nassim78belabed-gif/ipod-ok-computer/README.md

# iPod OK Computer Edition : ESP32-S3




Un iPod Classic refait de zéro : lecteur MP3 sur carte SD, écran couleur 2,4", DAC I2S et 6 boutons, pour environ 33 € de composants. Firmware, PCB (2 cartes) et boîtier 3D sont conçus de bout en bout, de la lecture des tags ID3 au transfert de musique par WiFi.

> Projet repris de zéro en septembre 2026 avec un nouveau brochage (firmware fonctionnel sur breadboard depuis fin septembre).

## Ce que j'ai fait

- **Firmware** en C++ (Arduino / ESP32) : navigation Artistes / Albums / Morceaux, lecture MP3 en I2S, pochettes, lecture des tags ID3.
- **Transfert de musique par WiFi** depuis un téléphone ou un PC, avec rangement automatique d'après les tags.
- **PCB** en deux cartes, générées par script, avec leurs fichiers de fabrication.
- **Boîtier** en deux coques, généré en CadQuery à partir des cotes des PCB.
- **Easter eggs** par album (thèmes, messages, code secret aux boutons).

## Matériel

| Composant | Détail |
|---|---|
| Microcontrôleur | ESP32-S3-DevKitC-1 **N16R8** (16 Mo flash, 8 Mo PSRAM octal) |
| Écran | ILI9341 2,4" 240x320 SPI, module avec lecteur SD intégré (tactile non utilisé) |
| Audio | DAC I2S PCM5102A (module **CJMCU-5102**, 11 broches), sortie jack LINE OUT |
| Commandes | 6 boutons poussoirs vers GND (pull-up interne) |

## Coût

Prix indicatifs (AliExpress / Amazon).

| Composant | Prix |
|---|---|
| ESP32-S3-DevKitC-1 N16R8 | ~8 € |
| Écran ILI9341 2,4" avec lecteur SD | ~8 € |
| DAC PCM5102A (module CJMCU-5102) | ~5 € |
| Carte microSD 32 Go | ~5 € |
| 6 boutons poussoirs | ~2 € |
| Breadboard + fils (prototype) | ~5 € |
| **Total version breadboard** | **~33 €** |

Version finale V1, portable sur batterie :

| Composant | Prix |
|---|---|
| ESP32, écran, DAC, microSD, boutons (voir ci-dessus) | ~28 € |
| Batterie LiPo YL 603450 (3,7 V, 1200 mAh, protégée) | ~8 € |
| Chargeur TP4056 | ~1 € |
| Régulateur 3,3 V, interrupteur, prise JST | ~3 € |
| PCB (2 cartes, fabrication type JLCPCB) | ~10 € |
| Boîtier imprimé en 3D | ~15 € |
| **Total version portable V1** | **~65 €** |

La V2 (molette cliquable iPod 4G à la place des boutons) ajoute le prix de la molette : ~10 à 15 € d'occasion.

## Fonctionnalités

Validées sur breadboard (firmware `firmware/ipod/`) :
- **Menus** Artistes / Albums / Morceaux, écran **Lecture en cours** (pochette, progression, volume), enchaînement des morceaux, pause, précédent / suivant, avance rapide.
- **Pochettes** : image intégrée au MP3, `/covers/<album>.jpg|.bmp`, `cover.jpg` / `folder.jpg` du dossier ; les JPG sont redimensionnés pour remplir le cadre.
- **Transfert MP3 par WiFi** : menu « Transfert MP3 », envoi de plusieurs MP3 d'un coup depuis un téléphone ou un PC, rangement automatique dans `/Music/<artiste>/<album>/` d'après les tags. Le WiFi n'est allumé que dans ce menu.
- **Easter eggs par album** : thème de couleurs, messages sur certaines pistes (fixes, défilants, « glitch ») et code secret aux boutons, décrits dans un fichier `easter.txt` par album (voir le dossier `easter/`).
- **Commandes série** : mêmes actions que les boutons (`m p < > + -`) et maintenance de la SD (liste, suppression, diagnostic des tags), via `outils/serie.py`.

Volume limité à 19/21 (au-delà, la sortie du DAC sature) ; départ à 16.

## Difficultés rencontrées

- **Écran et SD sur le même bus SPI.** L'ILI9341 ne libère pas sa broche SDO et bloquait la SD. Solution : le MISO de l'écran n'est pas câblé, et le firmware relâche toujours un CS avant d'activer l'autre.
- **Broches interdites.** Avec la PSRAM octal du N16R8, les GPIO 26 à 37 sont réservés : le brochage a dû être refait autour de cette contrainte.
- **Crash de la bibliothèque audio.** Certains MP3 provoquaient une division par zéro dans ESP32-audioI2S. J'ai corrigé la bibliothèque et gardé une copie patchée dans le dépôt (voir `LISEZMOI.md` du dossier).
- **WiFi et audio.** Le WiFi perturbait le son, donc il n'est allumé que dans le menu de transfert.
- **Saturation du DAC.** Au-delà de 19/21, la sortie sature : le volume est plafonné.
- **Passage au PCB.** Les cartes sont générées par script plutôt que dessinées à la main, ce qui permet de modifier le brochage et de régénérer tout le routage d'un coup.

## Brochage

| Fonction | GPIO |
|---|---|
| SPI SCK / MOSI / MISO (écran + SD) | 8 / 17 / 18 |
| SD CS | 16 |
| TFT CS / DC / RST | 11 / 9 / 10 |
| I2S BCK / DIN / LRCK | 7 / 6 / 5 |
| Boutons MENU / PLAY / PREV / NEXT / VOL+ / VOL- | 42 / 41 / 40 / 39 / 38 / 1 |

Rétroéclairage de l'écran sur 3V3 direct. Détails et contraintes : [hardware/wiring.md](hardware/wiring.md).

## PCB et boîtier

- **PCB v_final1** ([hardware/pcb_v_final1](hardware/pcb_v_final1/LISEZ-MOI.md)) : 2 cartes reliées par câble.
  - Carte logique (77 x 95 mm) : ESP32-S3 DevKit + PCM5102A + connecteurs vers l'écran, la SD et la façade boutons.
  - Carte façade (42,6 x 72,2 mm) : les 6 boutons en grille 2x3.
  - Le module écran ILI9341+SD reste externe, câblé à la carte logique.
  - Les cartes sont générées par script (`generateur/`) et les fichiers KiCad du PCB sont dans `kicad/`. [CONNEXIONS.md](hardware/pcb_v_final1/CONNEXIONS.md) liste toutes les connexions et tient lieu de schéma.
- **Boîtier v1** ([hardware/boitier_v1](hardware/boitier_v1/LISEZ-MOI.md)) : 2 coques (avant + arrière), 83 x 131 x 27 mm, générées en CadQuery à partir des cotes des PCB. **Provisoire** : plus large que le PCB pour laisser place à un écran et à des accessoires.

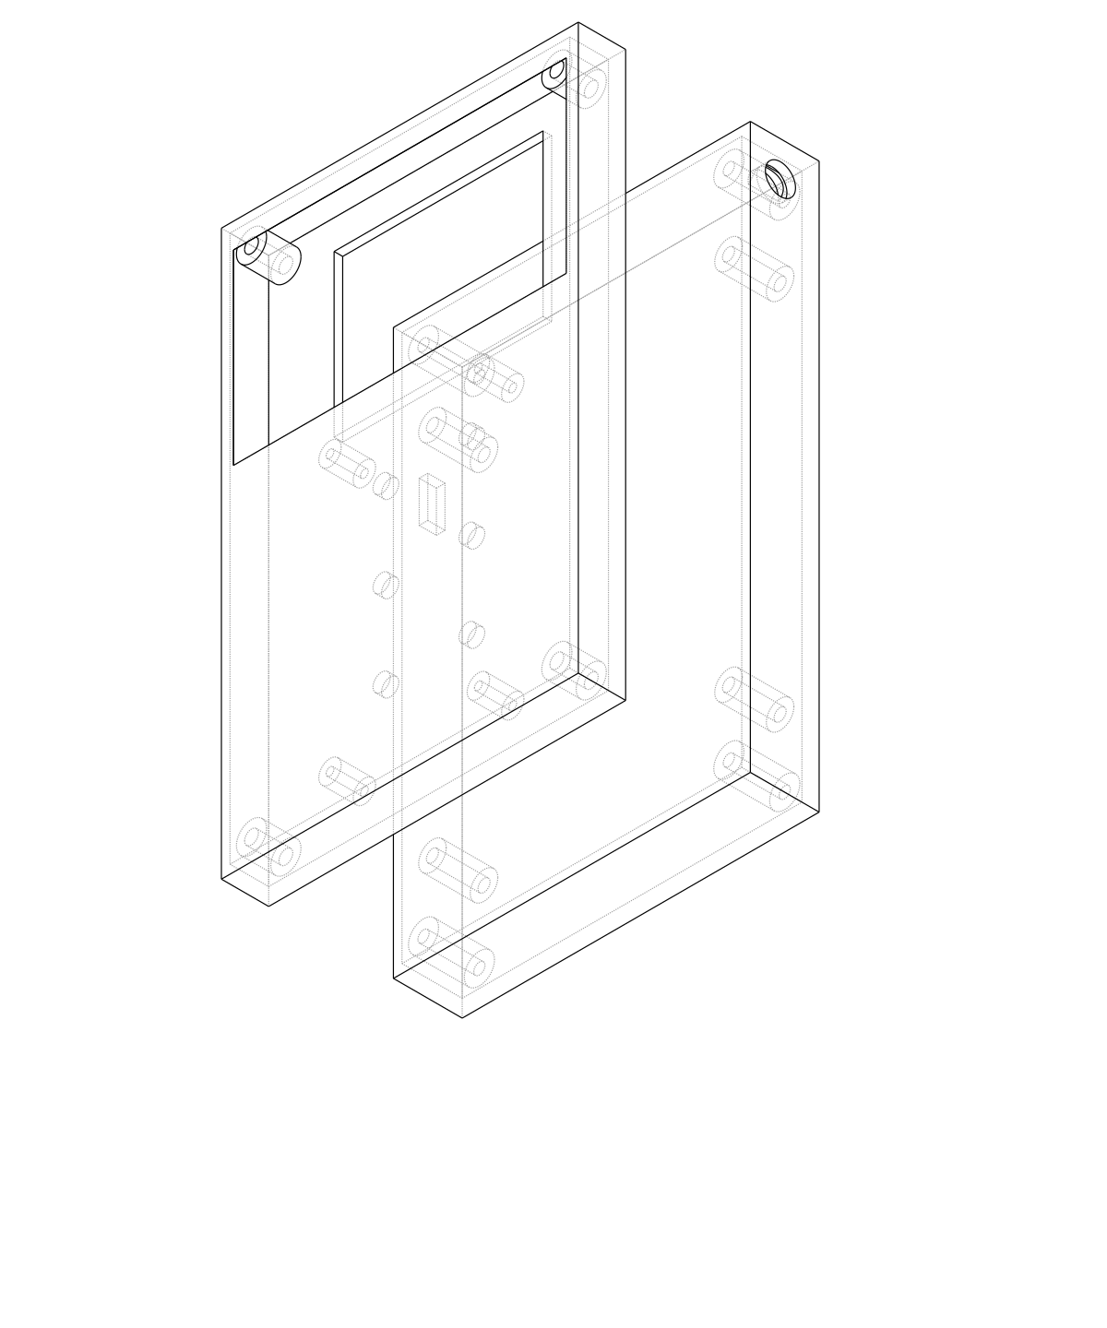
[picture p1: hardware/boitier_v1/preview_iso.png]
Boîtier


## Avancement

| Étape | État |
|---|---|
| Carte : puce, flash 16 Mo, PSRAM 8 Mo | ✅ testé (`test_carte`) |
| 1. SD : montage, liste, écriture/relecture | ✅ testé (`test_sd`, `liste_sd`) |
| Lecture des tags ID3 et du format MP3 | ✅ testé (`tags_sd`) |
| 2. Écran + SD + pochette | ✅ testé (`test_ecran_sd`) |
| 3. Boutons avec anti-rebond | ⏳ géré par le firmware, test dédié prêt (`test_boutons`) mais pas lancé |
| 4. Lecture MP3 vers le PCM5102A en I2S | ✅ testé (`test_bip`, `test_audio`) |
| 5. Interface iPod : Artistes, Albums, Morceaux, Lecture en cours, volume | ✅ firmware `firmware/ipod/` |
| 6. Transfert MP3 par WiFi | ✅ validé (25 MP3, ~0,3 Mo/s) |
| Easter eggs par album | ✅ essayés sur la carte |
| Améliorations d'interface (moteur d'affichage en PSRAM, polices, Cover Flow, playlists…) | ⏳ prévues |
| PCB : support DAC 11 broches, alimentation, découplage, pistes I2S courtes | ⏳ corrections à faire avant fabrication |
| V1 sur batterie (LiPo YL 603450, chargeur, mesure de tension) | ⏳ à ajouter au PCB |
| V2 : molette cliquable iPod 4G | ⏳ plus tard |

Tests faits sur breadboard uniquement : le PCB n'est pas encore fabriqué.

## Compilation

Outils : Arduino IDE 2 ou [arduino-cli](https://arduino.github.io/arduino-cli/), core **esp32 by Espressif 3.x**.

Bibliothèques : **Adafruit ILI9341** (+ Adafruit GFX, Adafruit BusIO), **TJpg_Decoder** (pochettes JPG). Audio : **ESP32-audioI2S** (schreibfaul1) 4.0.0, **copie patchée incluse dans le dépôt** (`firmware/ipod/src/ESP32-audioI2S/`, correctif d'une division par zéro sur certains MP3, voir son `LISEZMOI.md`) : rien à installer pour le firmware principal.

Réglages de la carte :

| Option | Valeur |
|---|---|
| Carte | ESP32S3 Dev Module |
| PSRAM | OPI PSRAM |
| Flash Size | 16 Mo |
| Partition | 16M Flash (3MB APP/9.9MB FATFS) |
| USB CDC On Boot | selon le port USB, voir ci-dessous |

**USB CDC On Boot** dépend du port USB branché :
- port **« COM »** (puce CH343) : désactivé, `Serial` sort sur l'UART0 ;
- port **« USB »** (USB natif) : activé, `Serial` sort sur l'USB natif.

Le firmware et les sketches de test écrivent sur `Serial` et `Serial0` : les messages restent lisibles quel que soit le port.

Exemple avec arduino-cli (port COM10) :

```
arduino-cli compile -u -p COM10 --fqbn esp32:esp32:esp32s3:PSRAM=opi,FlashSize=16M,CDCOnBoot=default,PartitionScheme=app3M_fat9M_16MB firmware/ipod
```

Remplacer `CDCOnBoot=default` par `CDCOnBoot=cdc` pour activer le CDC.

## Firmware

`firmware/ipod/` : `ipod.ino` (navigation, audio, boutons), `bibliotheque.ino` (tags ID3), `ecran.ino` (affichage), `easter.ino` (easter eggs), `web.ino` + `page_web.h` (WiFi, transfert), `ipod.h` (réglages).

## Sketches de test

| Sketch | Rôle |
|---|---|
| `firmware/tests/test_carte` | Infos puce, flash, test PSRAM, état des broches boutons |
| `firmware/tests/test_sd` | Montage SD, taille, liste de la racine, écriture/relecture de `test.txt` |
| `firmware/tests/liste_sd` | Liste récursive de toute la carte SD |
| `firmware/tests/tags_sd` | Tags ID3 (v1, v2.2 à 2.4) et format MPEG des MP3 de `/Music` |
| `firmware/tests/test_ecran_sd` | Écran (couleurs, texte, pochette) + liste de la SD |
| `firmware/tests/test_boutons` | Les 6 boutons avec anti-rebond (prêt, pas encore lancé) |
| `firmware/tests/test_bip` | Bip I2S vers le DAC |
| `firmware/tests/test_audio` | Lecture d'un MP3 de la SD vers le DAC |

## Carte SD

- Format **FAT32**
- Musique rangée dans `/Music/Artiste/Album/`, fichiers MP3 avec tags ID3 complets (titre, artiste, album, numéro de piste)
- MP3 testés : MPEG1 Layer III, 44,1 ou 48 kHz, stéréo

Pour ajouter de la musique sans retirer la carte : menu **Transfert MP3** sur l'iPod, puis page web (l'adresse s'affiche à l'écran) ou `curl -F "f=@fichier.mp3" http://<adresse>/api/envoi`.

Pour de bons fichiers : albums achetés sans DRM (Bandcamp, Qobuz, 7digital) ou CD rippés (Exact Audio Copy, fre:ac), qui arrivent avec tags et pochette.

## Structure du dépôt

```
ipod-ok-computer/
├── firmware/
│   ├── ipod/          # Firmware principal
│   └── tests/         # Sketches de test (un dossier par sketch)
├── easter/            # Modèles de fichiers easter.txt (un par album) + aperçus
├── outils/            # Scripts : commandes série, encodage de CD, journal série
├── hardware/
│   ├── wiring.md      # Brochage et contraintes
│   ├── pcb_v_final1/  # PCB actuel : carte logique + carte boutons (KiCad, gerbers, générateurs)
│   │   └── CONNEXIONS.md  # Liste des connexions (tient lieu de schéma)
│   ├── boitier_v1/    # Boîtier provisoire (STEP/STL, script CadQuery gen_case.py)
│   └── archives/      # Anciennes versions (v7, v8, breakout clickwheel), référence uniquement
└── LICENSE
```

## Licence

Le projet est sous licence **GPL-3.0**, voir [LICENSE](LICENSE).

Le dossier `firmware/ipod/src/ESP32-audioI2S/` est une copie patchée de la bibliothèque [ESP32-audioI2S](https://github.com/schreibfaul1/ESP32-audioI2S) (schreibfaul1), également sous **GPL-3.0** : sa licence d'origine est conservée dans ce dossier. Le projet entier est donc publié sous GPL-3.0.
