nassim78belabed-gif/ipod-ok-computer/easter/apercu/apercu.png

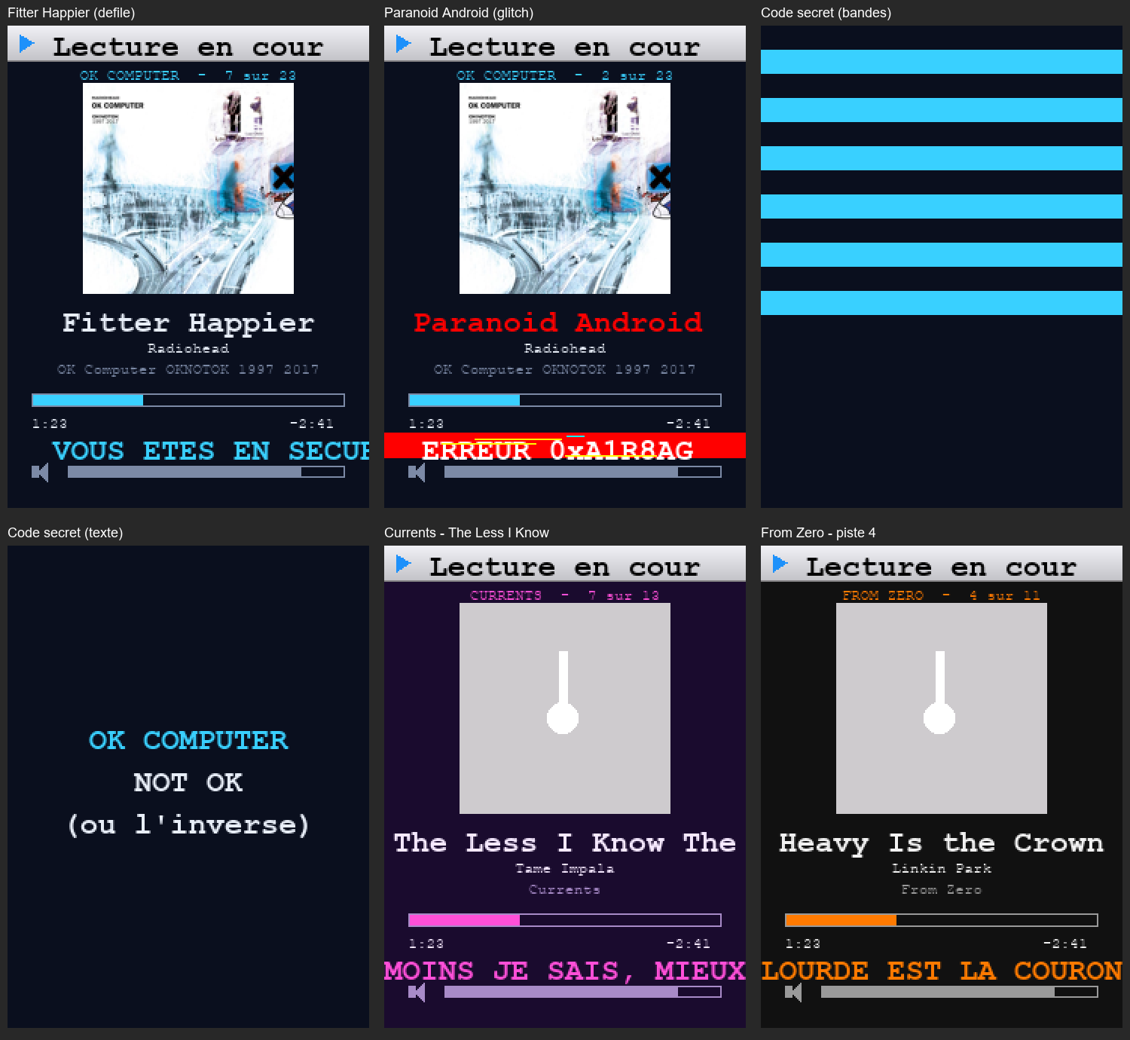
easter/apercu/apercu.png
