nassim78belabed-gif/ipod-ok-computer/hardware/boitier_v1/back_top.png

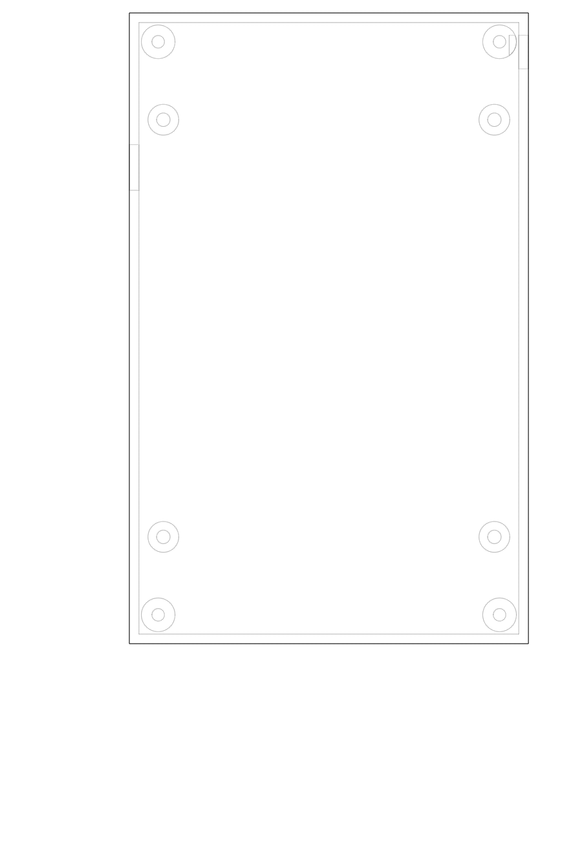
hardware/boitier_v1/back_top.png
