nassim78belabed-gif/ipod-ok-computer/hardware/boitier_v1/front_top.png

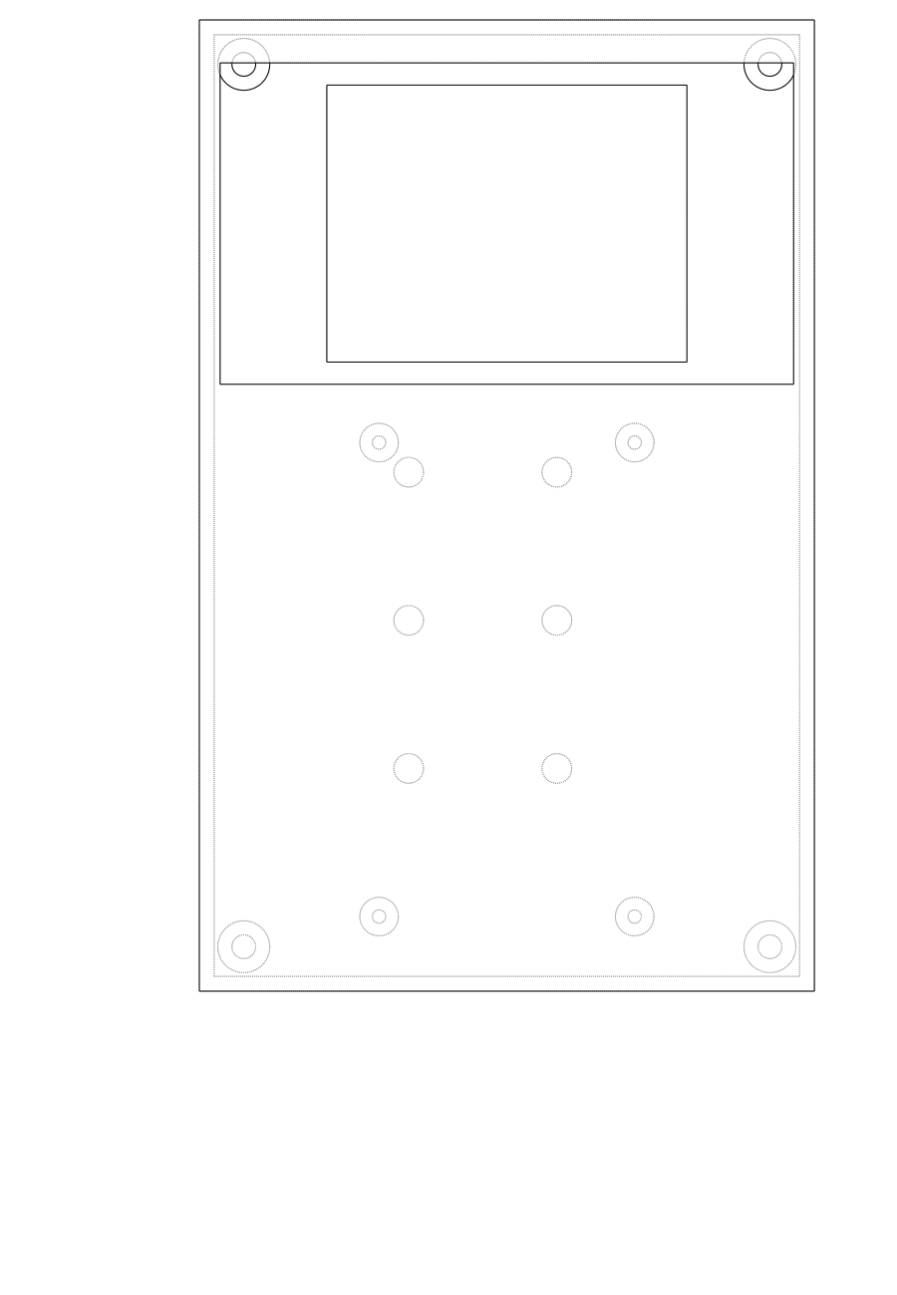
hardware/boitier_v1/front_top.png
