nassim78belabed-gif/ipod-ok-computer/hardware/pcb_v_final1/buttons/apercu_buttons.png

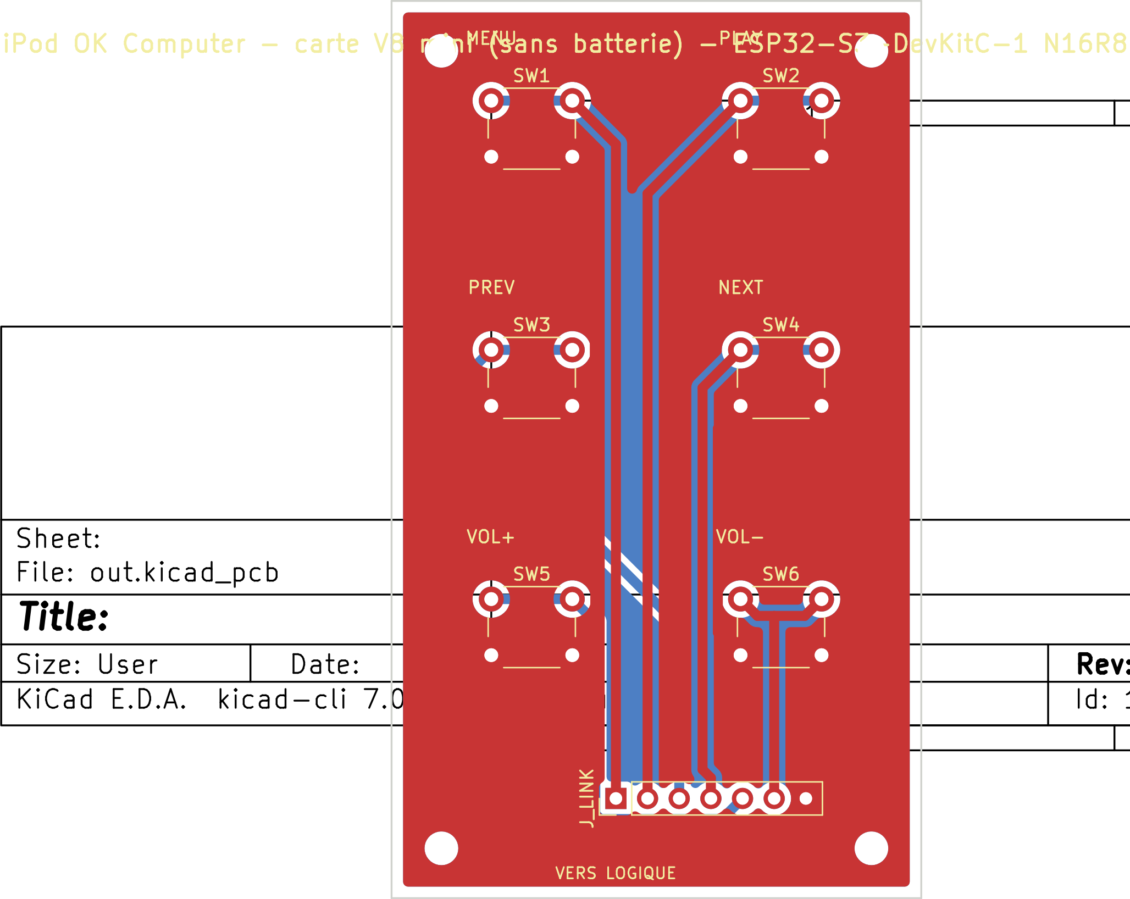
hardware/pcb_v_final1/buttons/apercu_buttons.png
