nassim78belabed-gif/ipod-ok-computer/hardware/pcb_v_final1/logic/apercu_logic.png

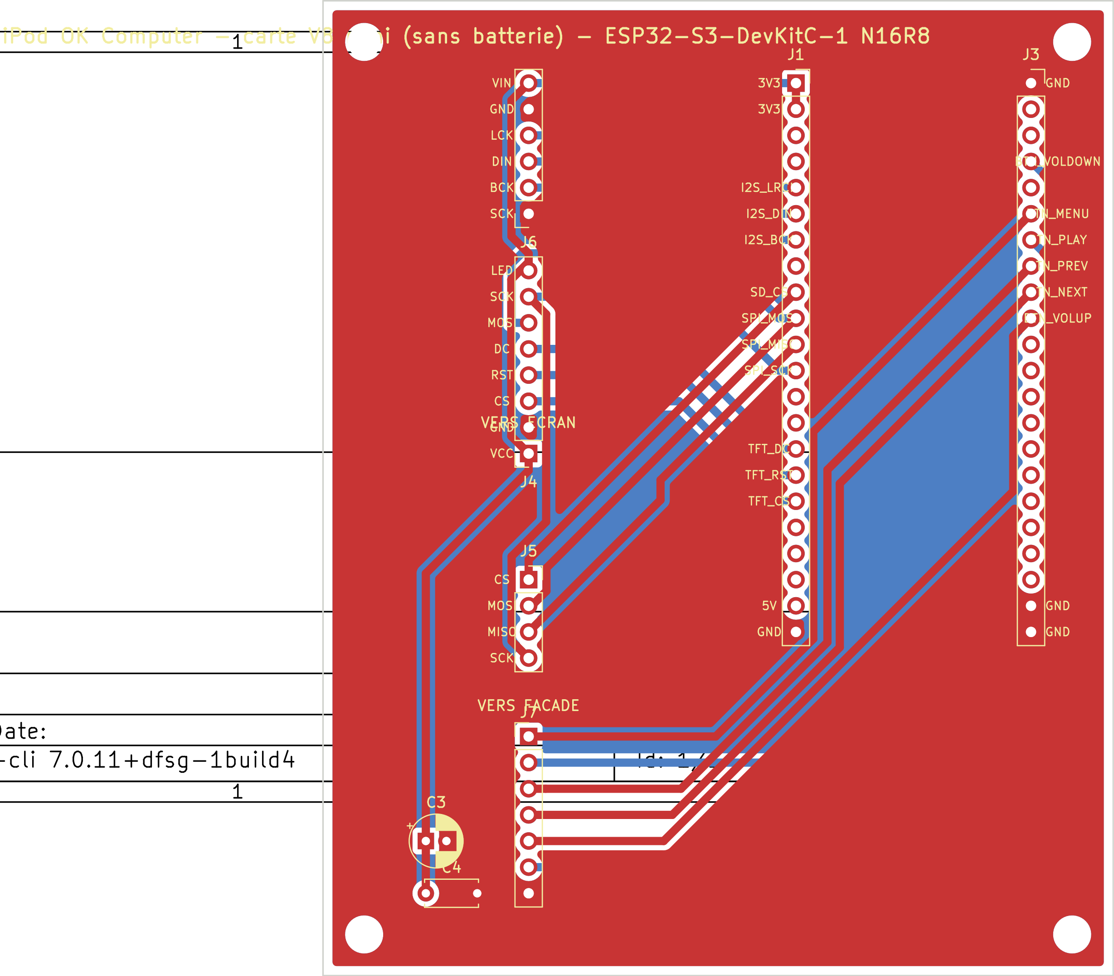
hardware/pcb_v_final1/logic/apercu_logic.png
