nassim78belabed-gif/ipod-ok-computer/hardware/archives/clickwheel_breakout/BOM.csv

Comment | Designator | Footprint | Manufacturer Part
FPC connector 0.5mm 8pos top contact | J1 | GH:SFV8R2STE1HLF | SFV8R-2STE1HLF (Amphenol/FCI)
