nassim78belabed-gif/ipod-ok-computer/hardware/boitier_v1/boitier_assemble_ecarte.step

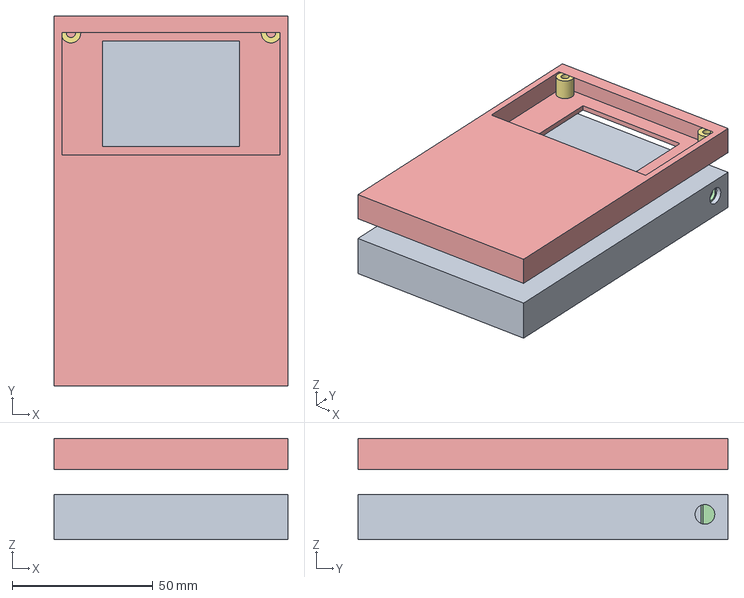
[picture p7: CAD file, 2026-10-21]
hardware/boitier_v1/boitier_assemble_ecarte.step
83.0 x 131.2 x 36.0 mm
back
front
