nassim78belabed-gif/ipod-ok-computer/hardware/boitier_v1/front_shell.step

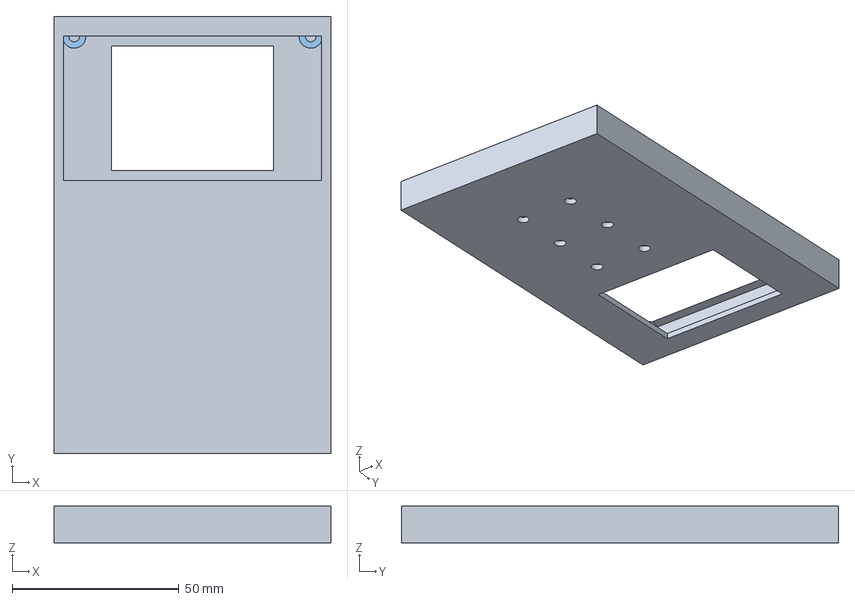
[picture p8: CAD file, 2026-10-21]
hardware/boitier_v1/front_shell.step
83.0 x 131.2 x 11.0 mm
