nassim78belabed-gif/ipod-ok-computer/hardware/pcb_v_final1/buttons/buttons_v_final1.step

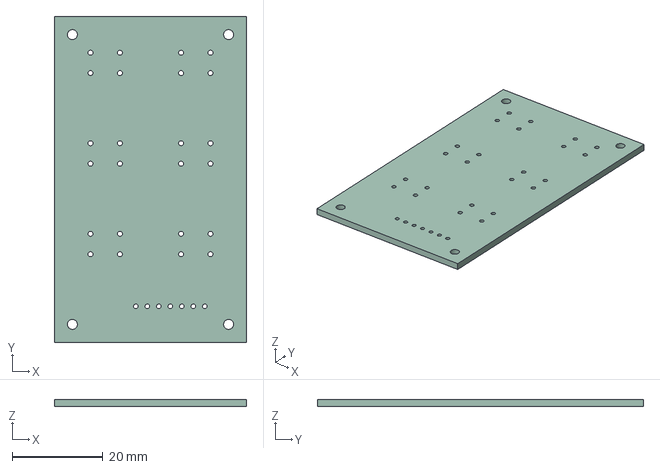
[picture p9: CAD file, 2026-10-21]
hardware/pcb_v_final1/buttons/buttons_v_final1.step
42.5 x 72.0 x 1.60 mm
