nassim78belabed-gif/ipod-ok-computer/hardware/pcb_v_final1/logic/logic_v_final1.step

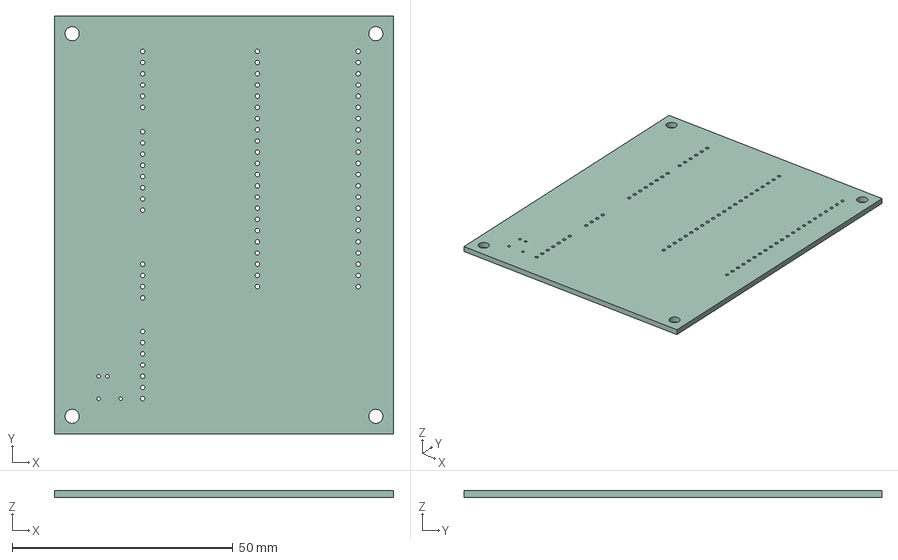
[picture p10: CAD file, 2026-10-21]
hardware/pcb_v_final1/logic/logic_v_final1.step
76.9 x 94.7 x 1.60 mm
