nassim78belabed-gif/ipod-ok-computer/hardware/boitier_v1/back_shell.step

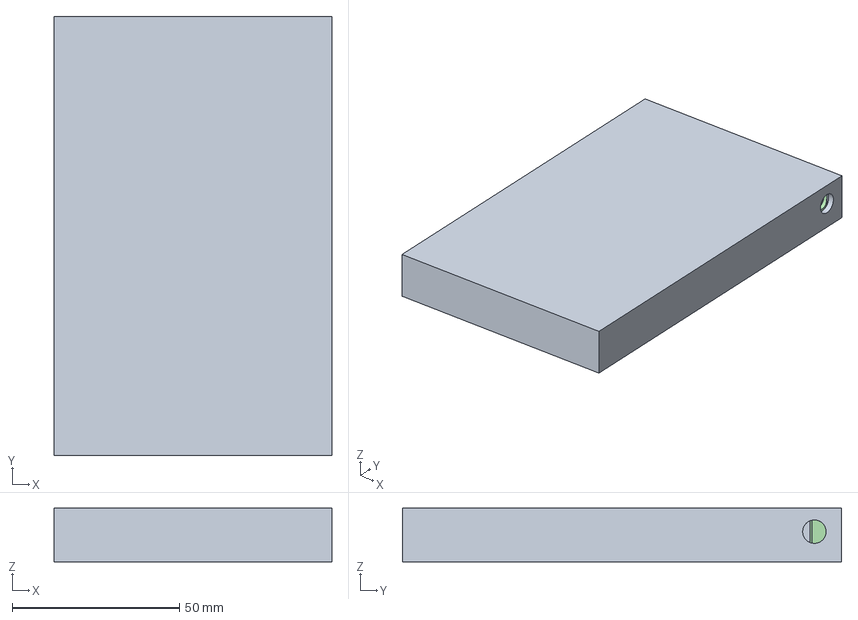
[picture p11: CAD file, 2026-10-21]
hardware/boitier_v1/back_shell.step
83.0 x 131.2 x 16.0 mm
