nassim78belabed-gif/ipod-ok-computer/(list of files, cad)

Other CAD files:
hardware/boitier_v1/back_shell.stl
hardware/boitier_v1/front_shell.stl
