nassim78belabed-gif/ipod-ok-computer/hardware/archives/ipod_v7/schema_ipod_v7.pdf

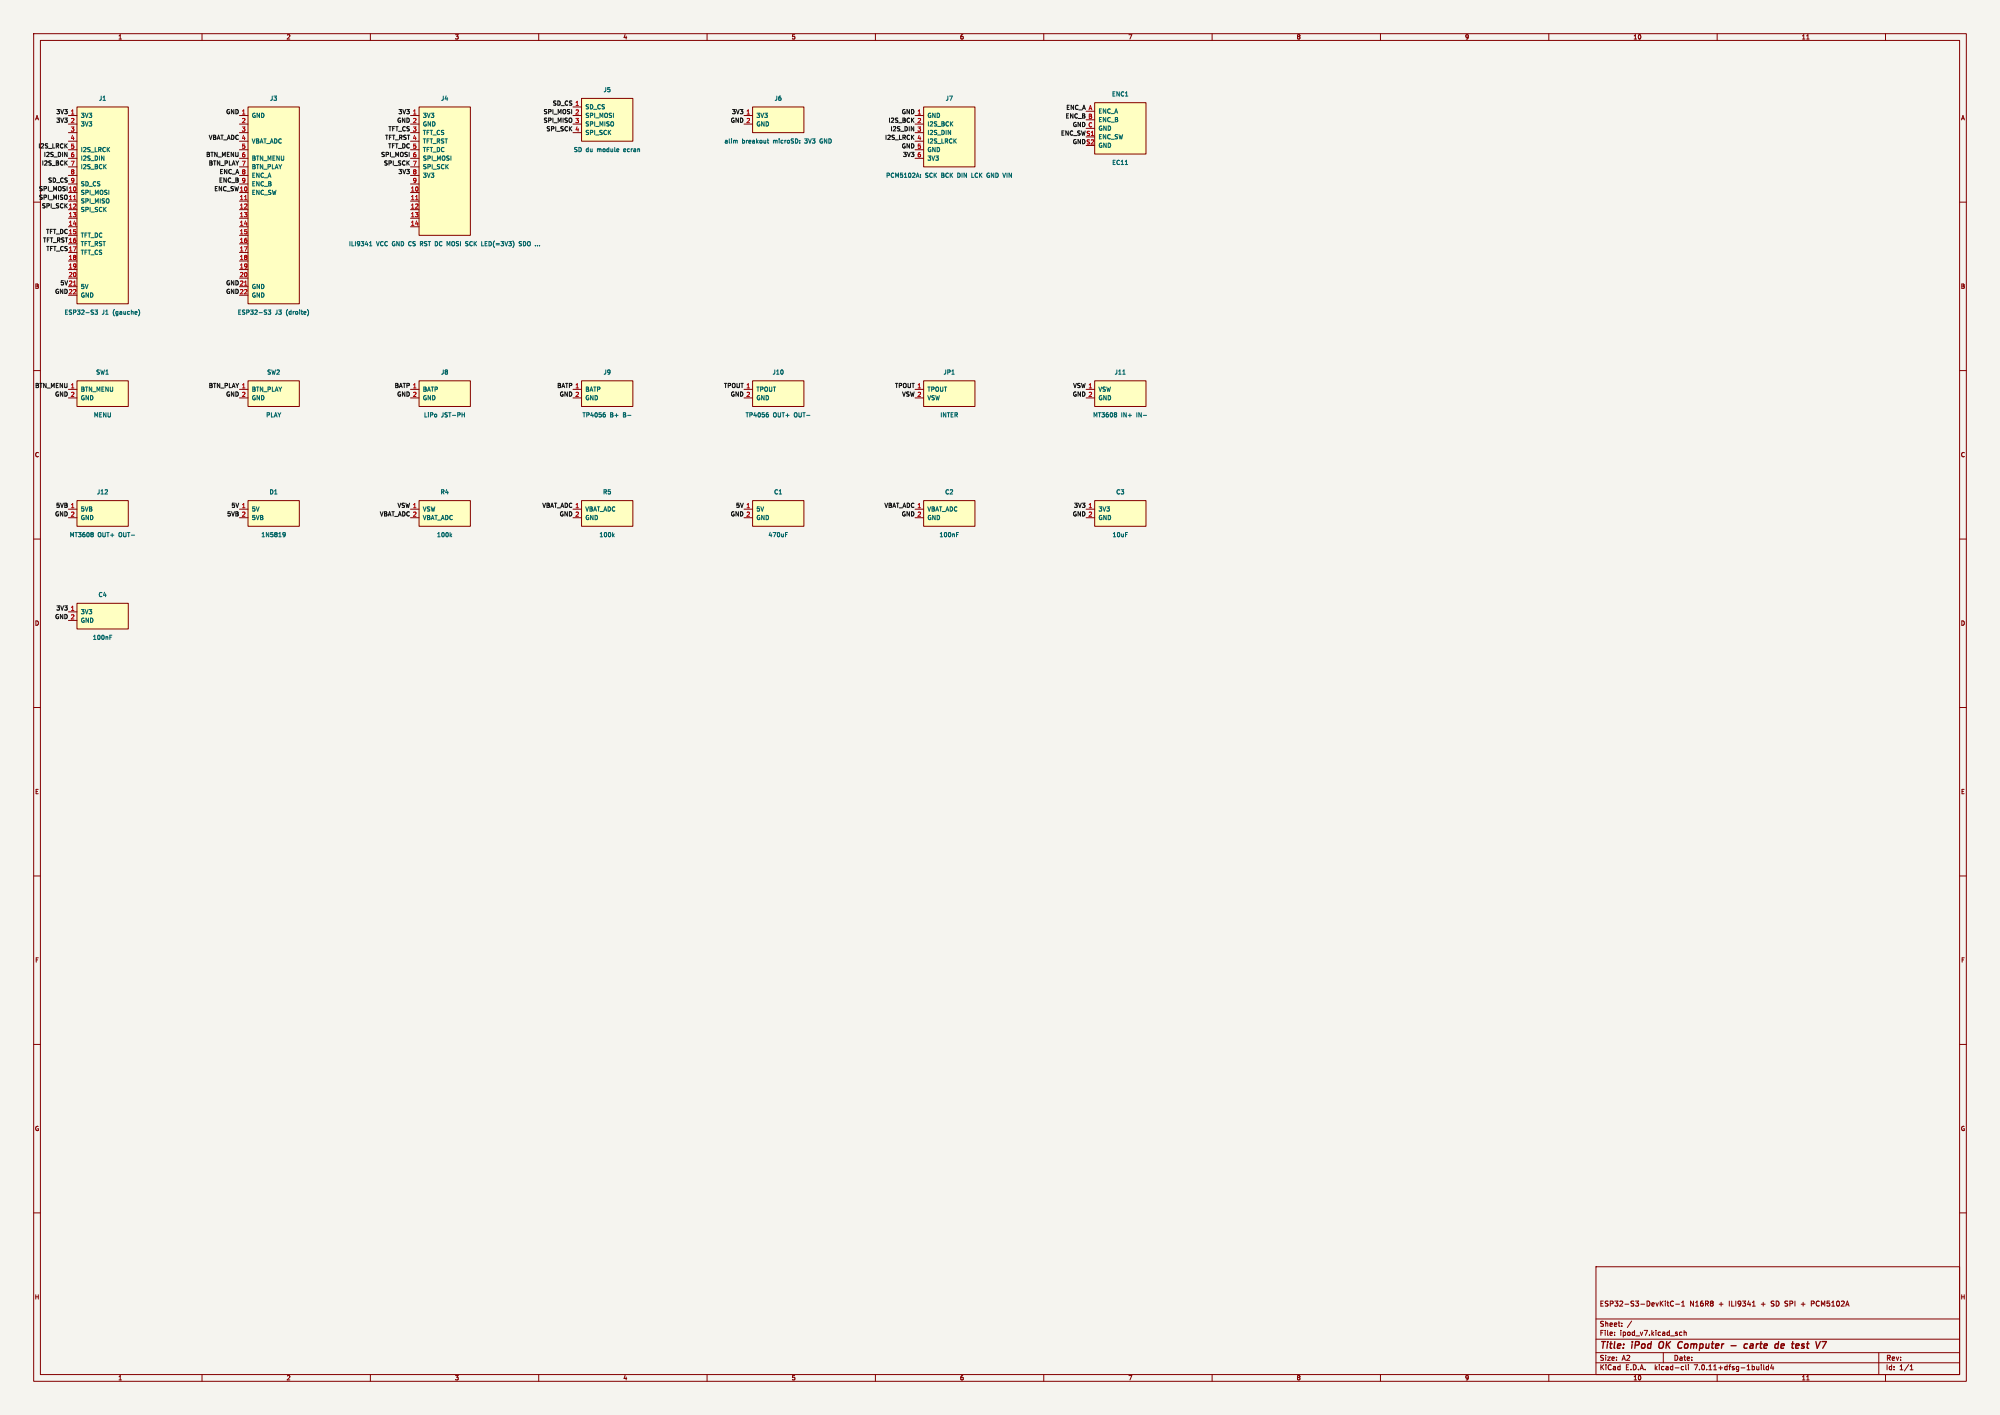
[picture p12: page 1]

J7 PCM5102A: SCK BCK DIN LCK GND VIN
