nassim78belabed-gif/ipod-ok-computer/hardware/archives/ipod_v8/schema_ipod_v8.pdf

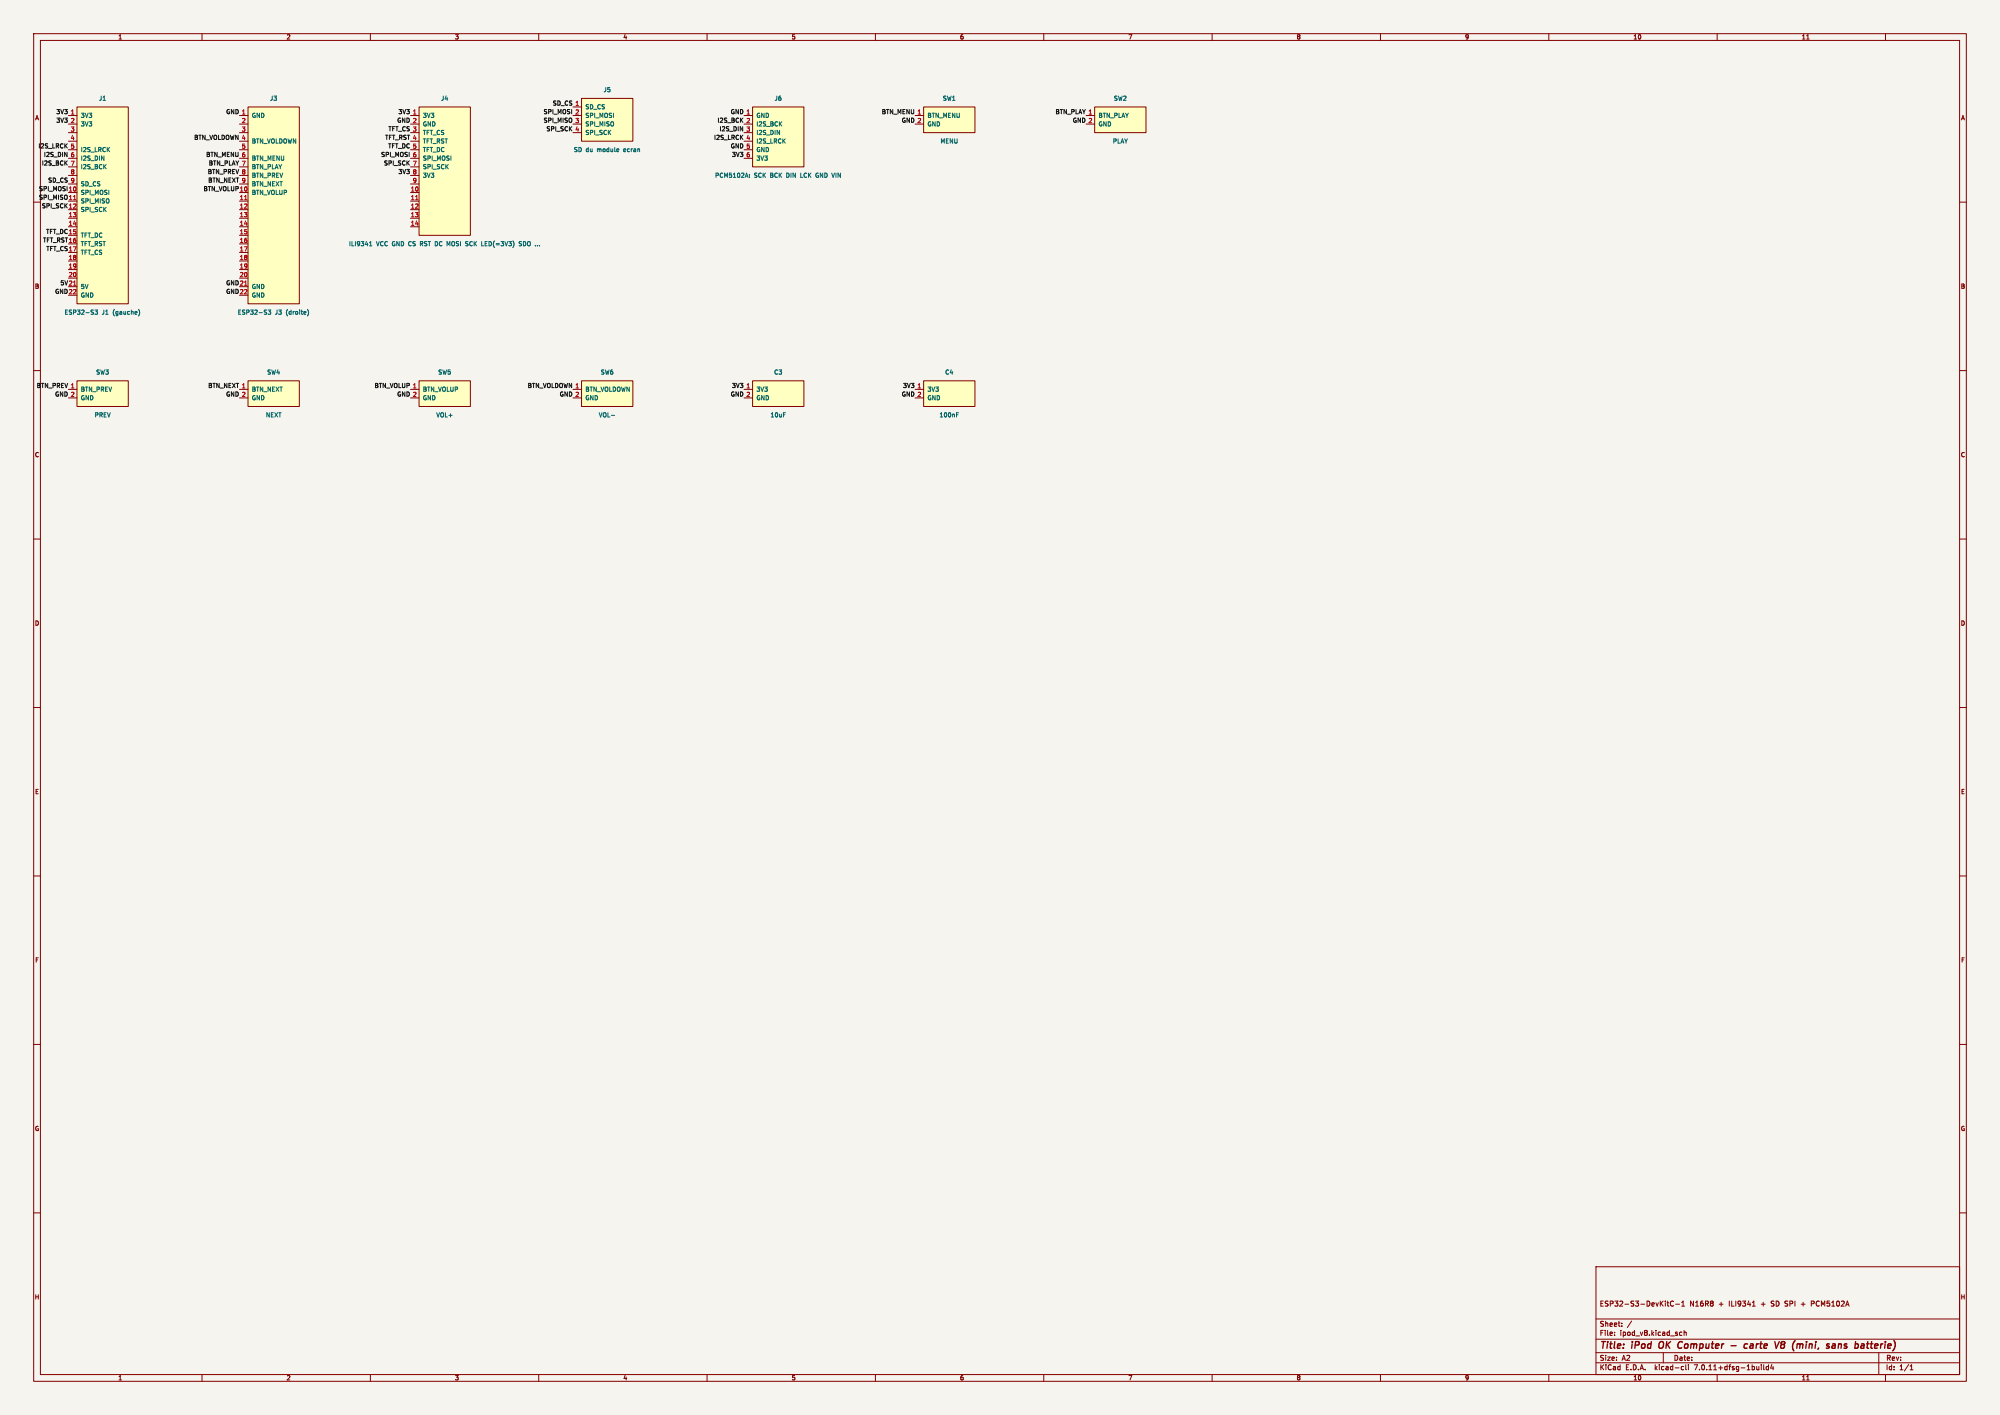
[picture p13: page 1]

J6 PCM5102A: SCK BCK DIN LCK GND VIN
