nassim78belabed-gif/ipod-ok-computer/hardware/pcb_v_final1/logic/kicad/logic_v_final1.kicad_pcb

## KiCad design hardware/pcb_v_final1/logic/kicad/logic_v_final1.kicad_pcb (2026-10-21)

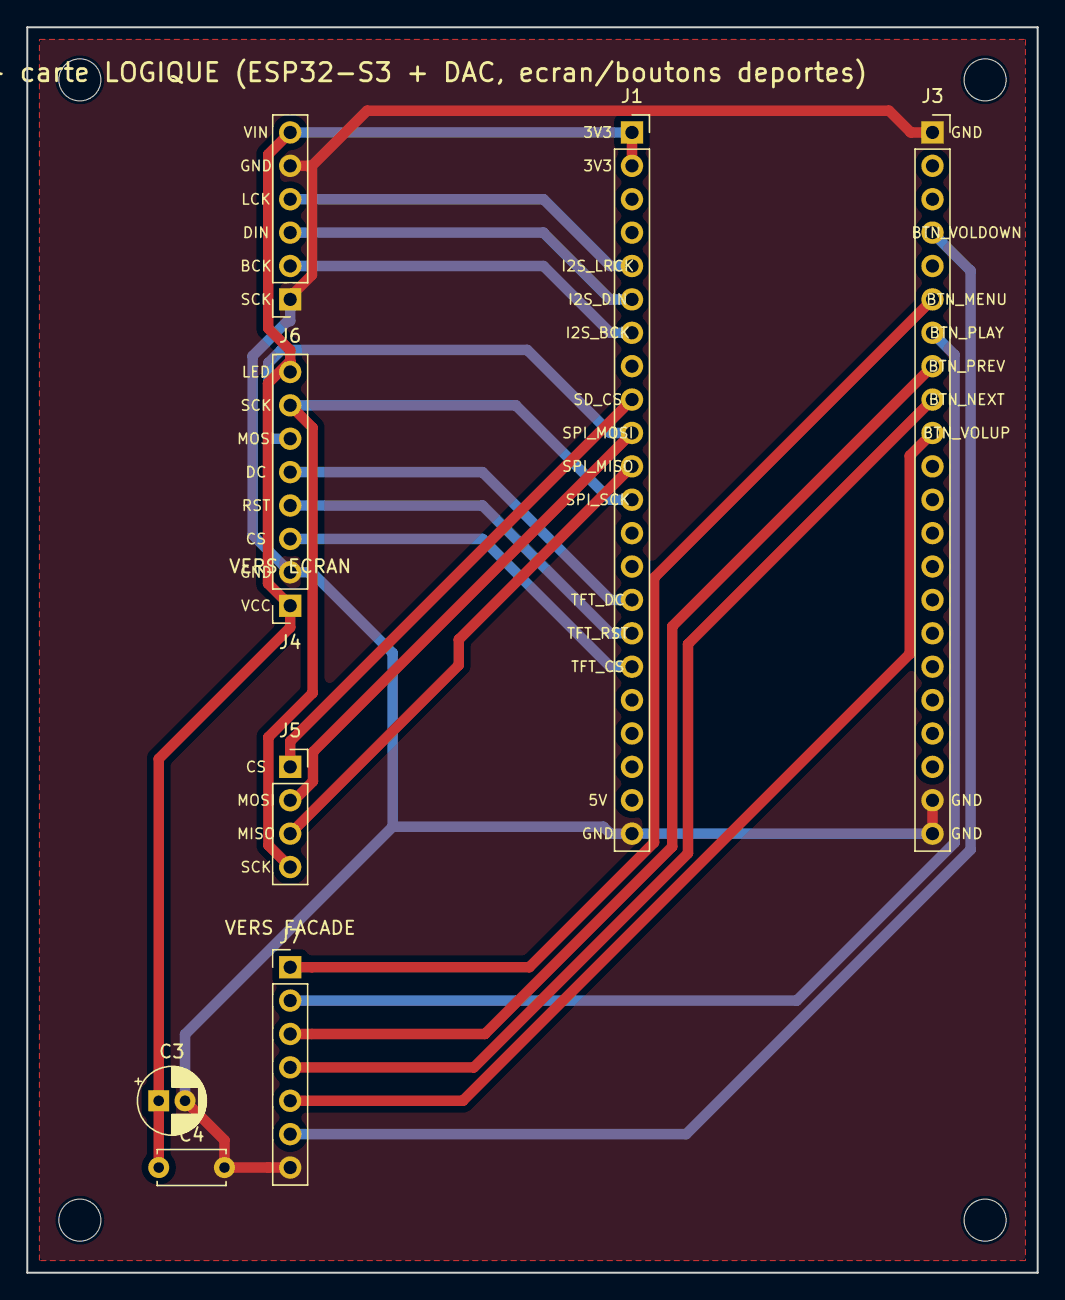
[picture p14: board logic_v_final1.kicad_pcb from above]

Board: 2 copper layers, 76.9 x 94.7 mm, 12 parts (0 on the bottom side), 18 nets.

Parts:
C3: 10uF; CP_Radial_D5.0mm_P2.00mm
C4: 100nF; C_Disc_D5.0mm_W2.5mm_P5.00mm
H1, H2, H3, H4: MountingHole_3.2mm_M3
J1: ESP32-S3 J1 (gauche); PinSocket_1x22_P2.54mm_Vertical
J3: ESP32-S3 J3 (droite); PinSocket_1x22_P2.54mm_Vertical
J4: VERS ECRAN: VCC GND CS RST DC MOSI SCK LED; PinSocket_1x08_P2.54mm_Vertical
J5: VERS SD ecran; PinSocket_1x04_P2.54mm_Vertical
J6: PCM5102A: SCK BCK DIN LCK GND VIN; PinSocket_1x06_P2.54mm_Vertical
J7: VERS FACADE: MENU PLAY PREV NEXT VOL+ VOL- GND; PinHeader_1x07_P2.54mm_Vertical

Connections:
3V3: C3.1, C4.1, J1.1, J1.2, J4.1, J4.8, J6.6
BTN_MENU: J3.6, J7.1
BTN_NEXT: J3.9, J7.4
BTN_PLAY: J3.7, J7.2
BTN_PREV: J3.8, J7.3
BTN_VOLDOWN: J3.4, J7.6
BTN_VOLUP: J3.10, J7.5
GND: C3.2, C4.2, J1.22, J3.1, J3.21, J3.22, J4.2, J6.1, J6.5, J7.7
I2S_BCK: J1.7, J6.2
I2S_DIN: J1.6, J6.3
I2S_LRCK: J1.5, J6.4
SD_CS: J1.9, J5.1
SPI_MISO: J1.11, J5.3
SPI_MOSI: J1.10, J4.6, J5.2
SPI_SCK: J1.12, J4.7, J5.4
TFT_CS: J1.17, J4.3
TFT_DC: J1.15, J4.5
TFT_RST: J1.16, J4.4
