nassim78belabed-gif/ipod-ok-computer/hardware/pcb_v_final1/buttons/kicad/buttons_v_final1.kicad_pcb

## KiCad design hardware/pcb_v_final1/buttons/kicad/buttons_v_final1.kicad_pcb (2026-10-21)

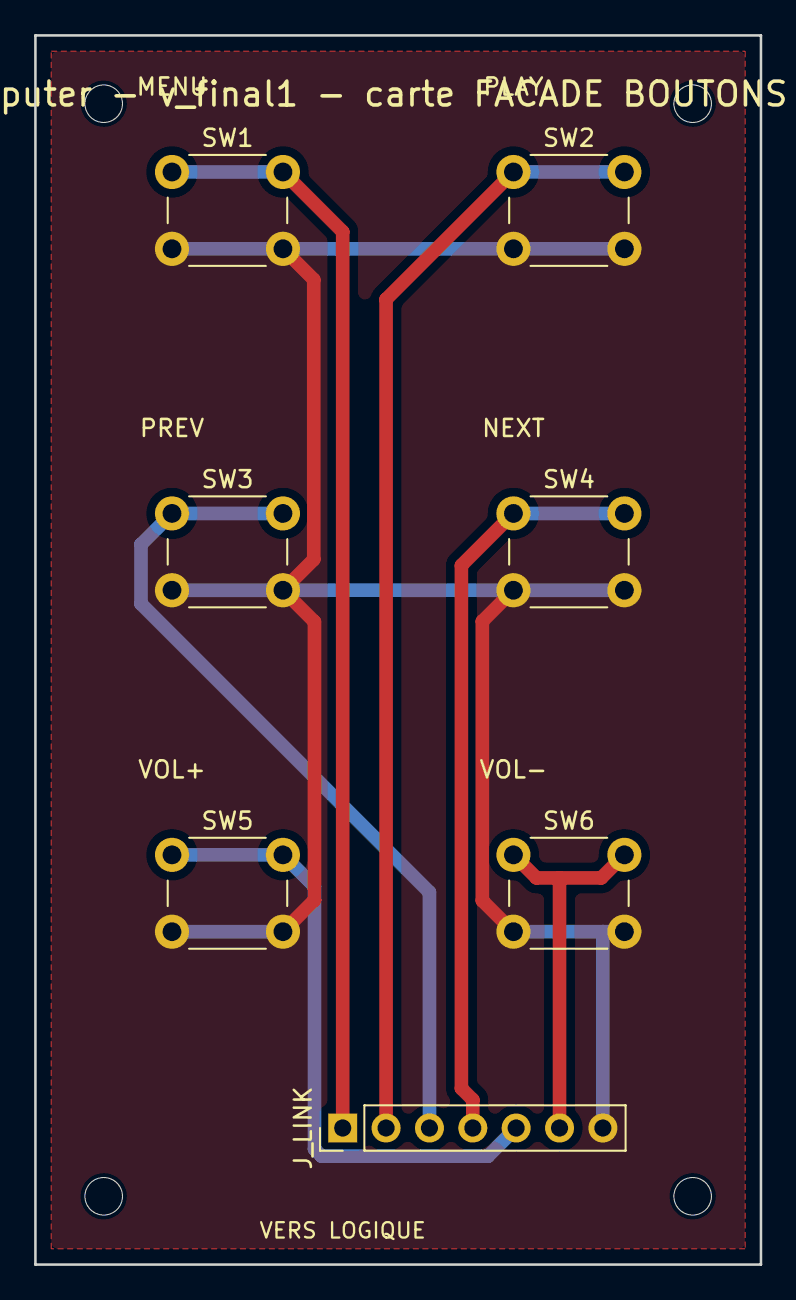
[picture p15: board buttons_v_final1.kicad_pcb from above]

Board: 2 copper layers, 42.5 x 72.0 mm, 11 parts (0 on the bottom side), 7 nets.

Parts:
H1, H2, H3, H4: MountingHole_2.2mm_M2
J_LINK: VERS CARTE LOGIQUE; PinHeader_1x07_P2.54mm_Vertical
SW1: MENU; SW_PUSH_6mm
SW2: PLAY; SW_PUSH_6mm
SW3: PREV; SW_PUSH_6mm
SW4: NEXT; SW_PUSH_6mm
SW5: VOL+; SW_PUSH_6mm
SW6: VOL-; SW_PUSH_6mm

Connections:
BTN_MENU: J_LINK.1, SW1.1
BTN_NEXT: J_LINK.4, SW4.1
BTN_PLAY: J_LINK.2, SW2.1
BTN_PREV: J_LINK.3, SW3.1
BTN_VOLDOWN: J_LINK.6, SW6.1
BTN_VOLUP: J_LINK.5, SW5.1
GND: J_LINK.7, SW1.2, SW2.2, SW3.2, SW4.2, SW5.2, SW6.2
