nassim78belabed-gif/ipod-ok-computer/firmware/ipod/tracker.h

// Donnees de l'ecran "Spidey Tracker" (easter.ino, style=N tracker)
// Carte du monde en points : 60 colonnes (6 degres de longitude) x 30 lignes (4,6 degres de latitude, de 83 N a 56 S),
// generee depuis Natural Earth (domaine public, ne_110m_land). Un "#" = un point de terre, dessine en 2x2 pixels tous les 4 pixels.
#pragma once
#define TK_COLS 60
#define TK_ROWS 30
static const char *const TK_CARTE[TK_ROWS] = {
  "..............#############.....##...........##.............",
  "..........##.####.#########............#....#####....#......",
  "...##...###########..######.......#....#.################...",
  "####################.####.##....############################",
  "..#############.###..##........#############################",
  "...##..########..###.........#.#######################..#...",
  "........#############.......##########################..#...",
  ".........############........#########################......",
  ".........###########........##########.###############......",
  ".........#########..........##.#######.#############.#......",
  "..........#######...........####...###############.##.......",
  "..........#######...........#######################.........",
  "...........###..#..........#######################..........",
  "............##.#.##........#############..#######...........",
  ".............###...........############...##..##..#.........",
  "...............#####.......############...##..##..#.........",
  ".................####.......##########........#..##.........",
  ".................#####.........#######........####..........",
  "................########.......######..........#######......",
  "................########........#####..........####..##.....",
  ".................#######........#####...............##......",
  "..................######........#######...........#####.....",
  "..................#####.........####.#...........######.....",
  "..................####..........####.#...........#######....",
  "..................####...........##..............#######....",
  "..................###............#...............#...##.....",
  ".................###..................................#....#",
  ".................##.......................................#.",
  ".................##.........................................",
  ".................##........................................."
};

// Reperes (pixels dans la carte de 240 x 120). Villes et statuts : liste du site tiers spideytracker.org (San Diego confirme ;
// New York, Los Angeles et Londres en rumeur), positions calculees depuis la longitude et la latitude.
// Los Angeles est decale de 13 pixels vers l'ouest (dans l'ocean) pour ne pas recouvrir San Diego (130 km d'ecart seulement, trop proche pour des pastilles de 16 pixels).
struct TkPin { int16_t x, y; bool confirme; const char *nom; };
static const TkPin TK_PINS[] = {
  {42, 43, true,  "SAN DIEGO"},
  {71, 37, false, "NEW YORK CITY"},
  {29, 44, false, "LOS ANGELES"},
  {120, 27, false, "LONDON"},
};
#define TK_NB 4
#define TK_IPOD_X 125   // "position actuelle" : l'iPod (Europe de l'Ouest, a ajuster)
#define TK_IPOD_Y 36
