nassim78belabed-gif/ipod-ok-computer/(commit log)

2026-10-21 iPod OK Computer Edition : firmware ESP32-S3, PCB et boîtier
    [BOM.csv, back_shell.step, back_shell.stl, boitier_assemble_ecarte.step, buttons_v_final1.kicad_pcb, buttons_v_final1.step, clickwheel_breakout.kicad_pcb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]
2026-10-21 Retire les tirets cadratins
