nassim78belabed-gif/ipod-ok-computer/(notices)

Notices in the files:
README.md:
License: GPL-3.0
